PhilopatearSalib/pcleaner/A0 poster.pptx

PCleaner

Abstract

Our projects goal was to offer daily caring routines to medium sized swimming pools , owned by 30-50 year old males or females , in a villa or a compound.

Function

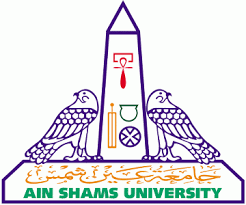
[picture p72: figure]

Ahmed Amr
Philopatear Salib
Nourhan Ayman

Product design

Design Thinking process

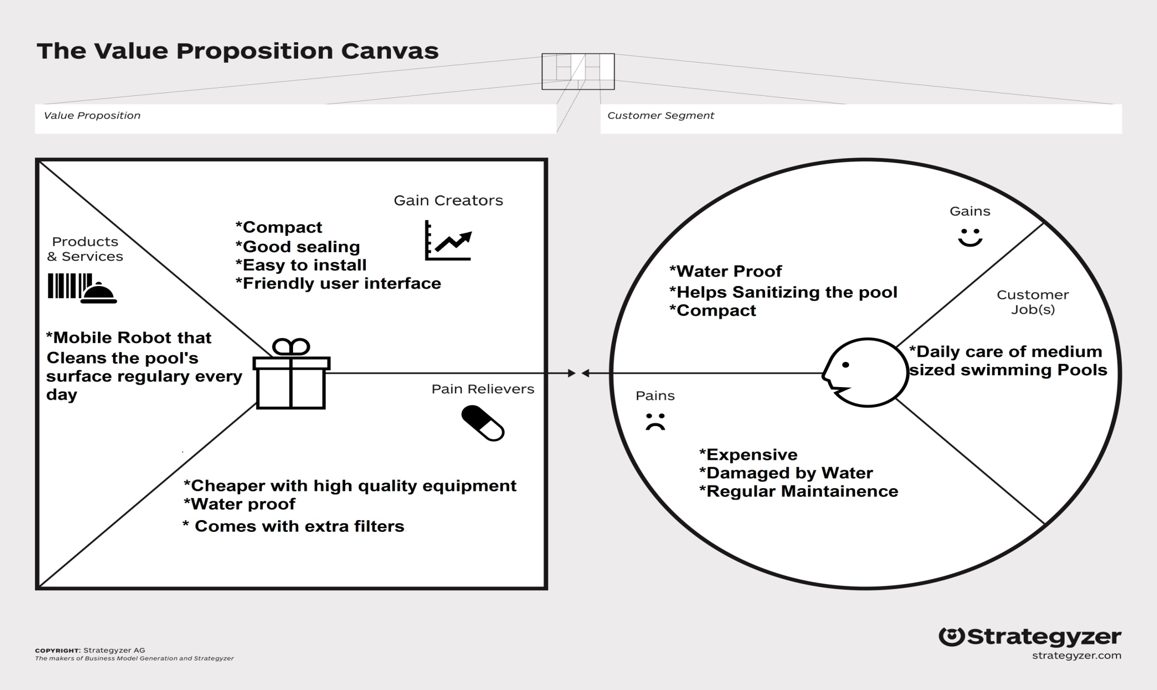
[picture p73: figure]

Business Model Canvas

Market research results

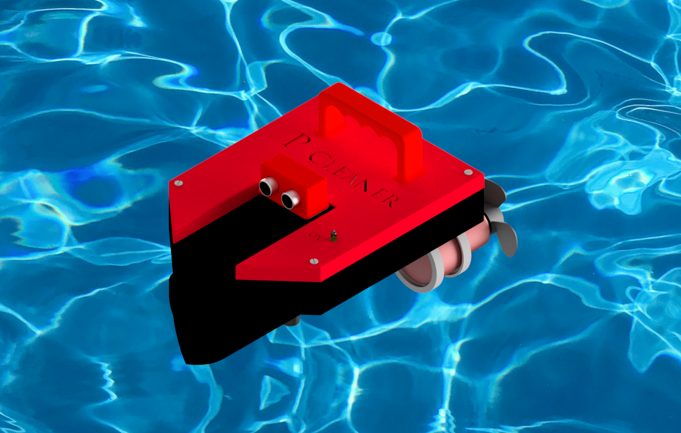
[picture p74: figure]

Our main goal was to clean any medium sized pool , in the most efficient way . And still maintaining privacy and safety. Our robot works autonomously , with a really simple user interface that requires no effort and has no complexity.

Project timeline

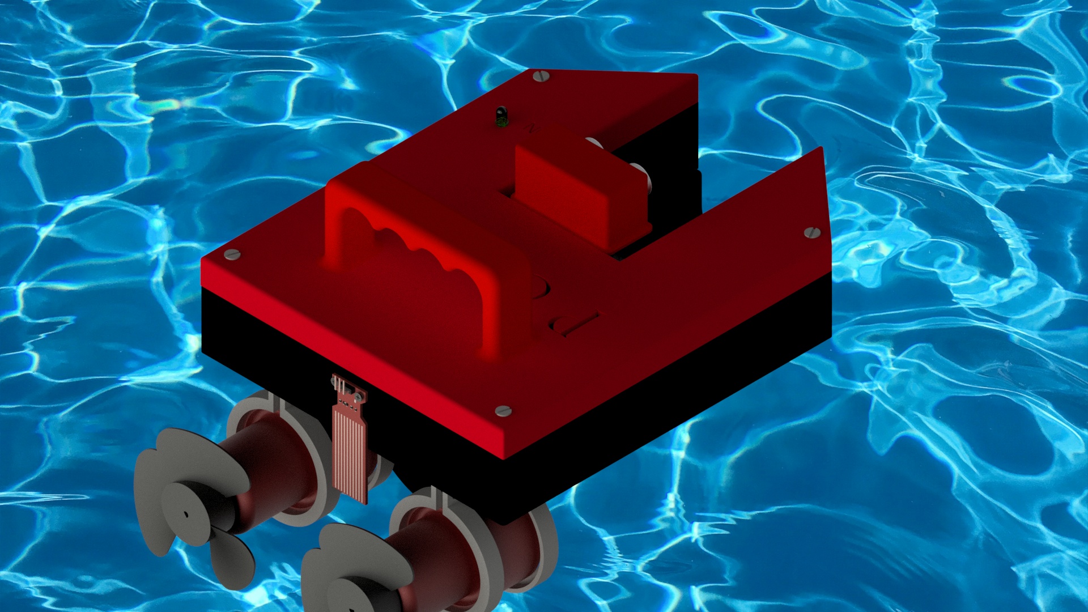
[picture p75: figure]
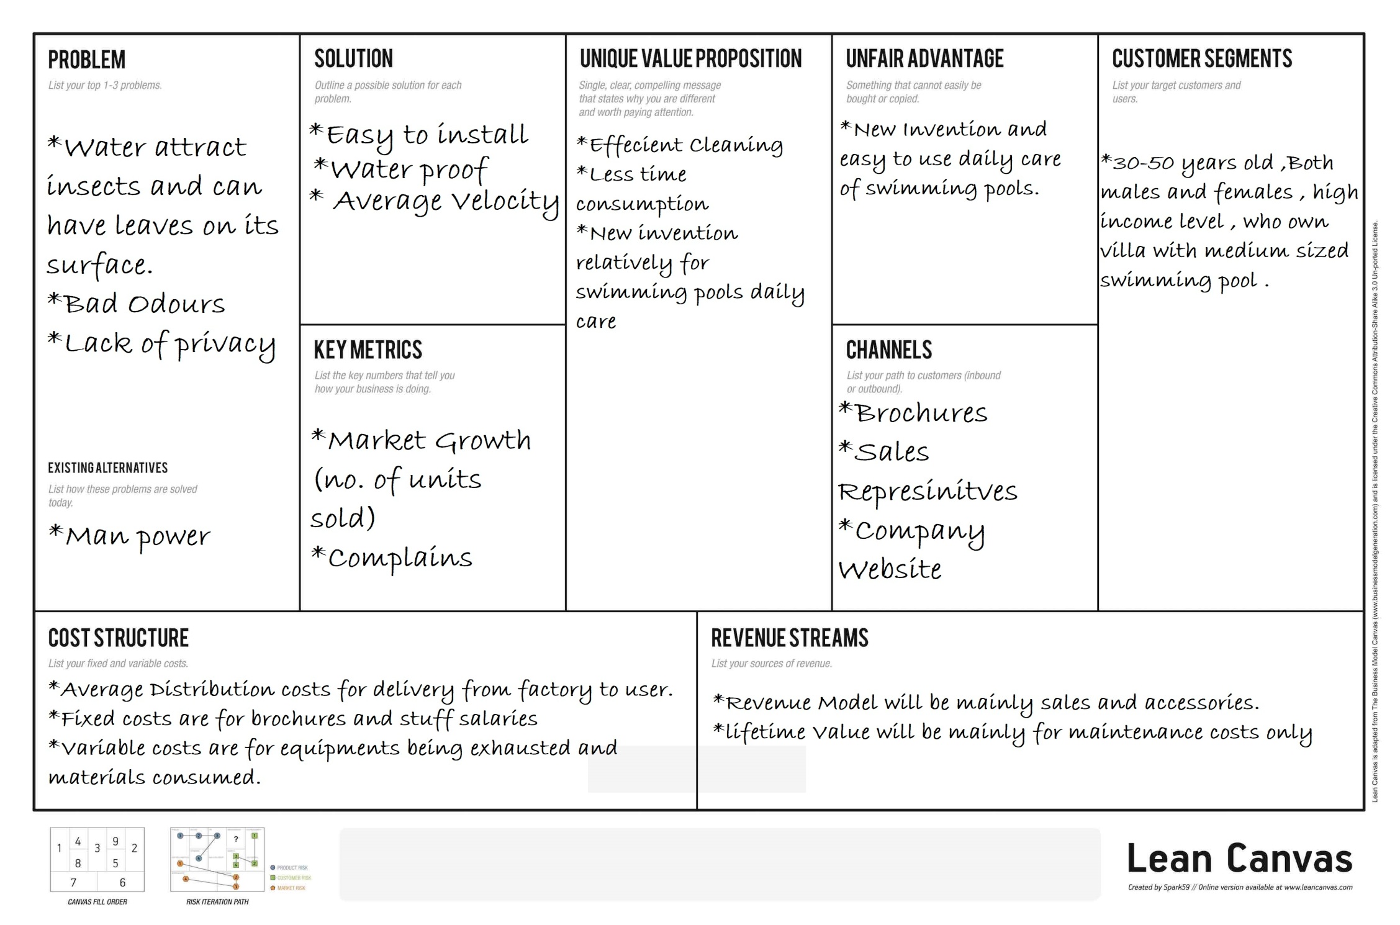
[picture p76: figure]

Lean Model Canvas

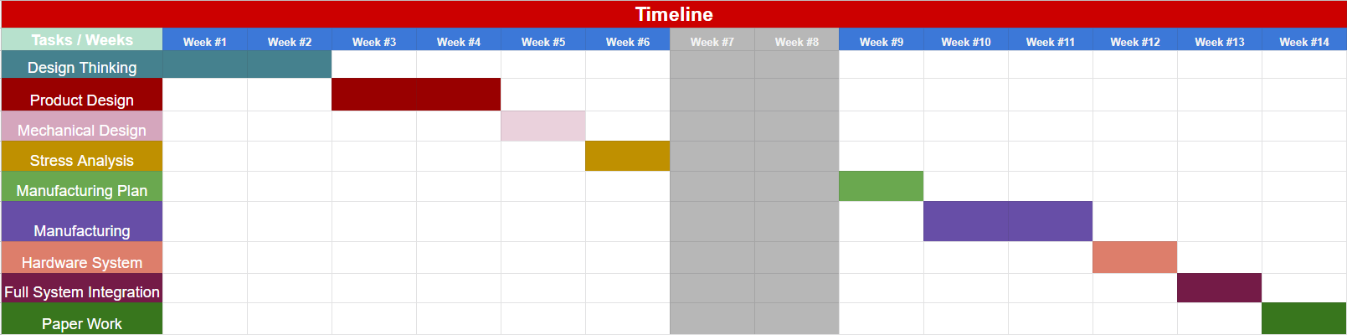
[picture p77: figure]

Specs and features

- Easy to install
- Compact
- Low time consumption cleaning
- Low maintenance time
- Very simple user interface

Bill of materials and cost

Electrical aspects


SID-Model

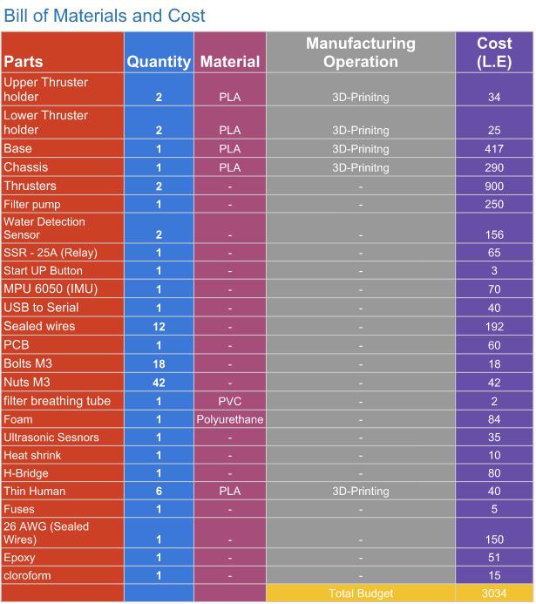
[picture p78: figure]
