PhilopatearSalib/pcleaner/56881405_650702132056410_6555122049436614656_n.jpg

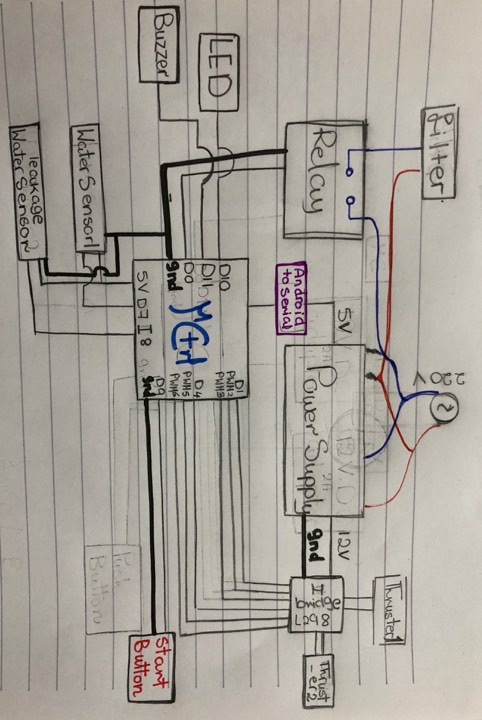
56881405_650702132056410_6555122049436614656_n.jpg
