PhilopatearSalib/pcleaner/AC to DC Converter/Capture.JPG

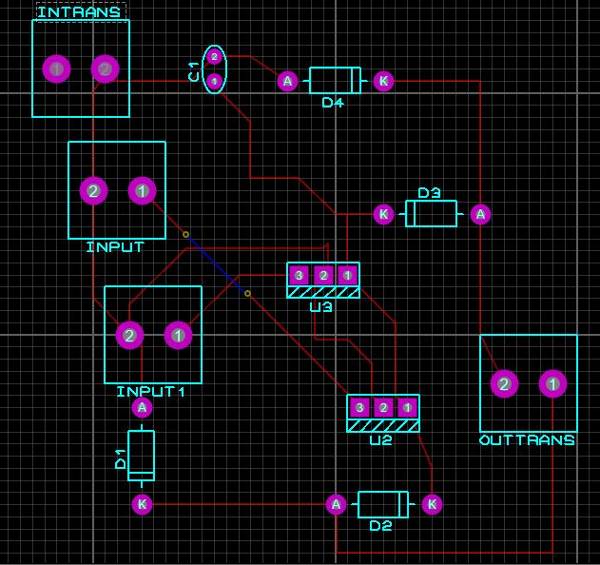
AC to DC Converter/Capture.JPG
