PhilopatearSalib/pcleaner/arduino/arduino.png

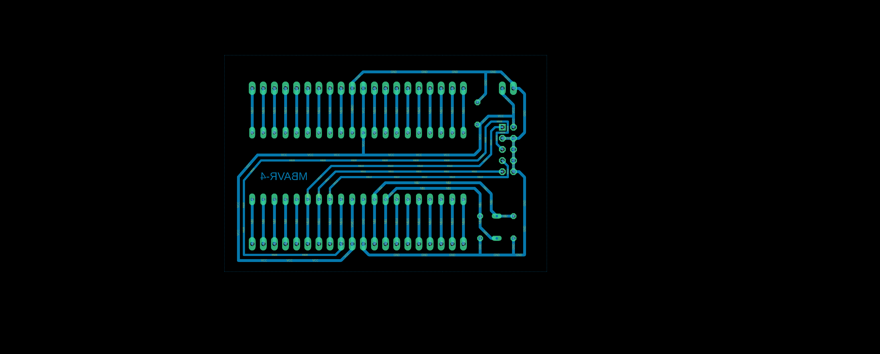
arduino/arduino.png
