PhilopatearSalib/pcleaner/Mother BlackBox.jpg

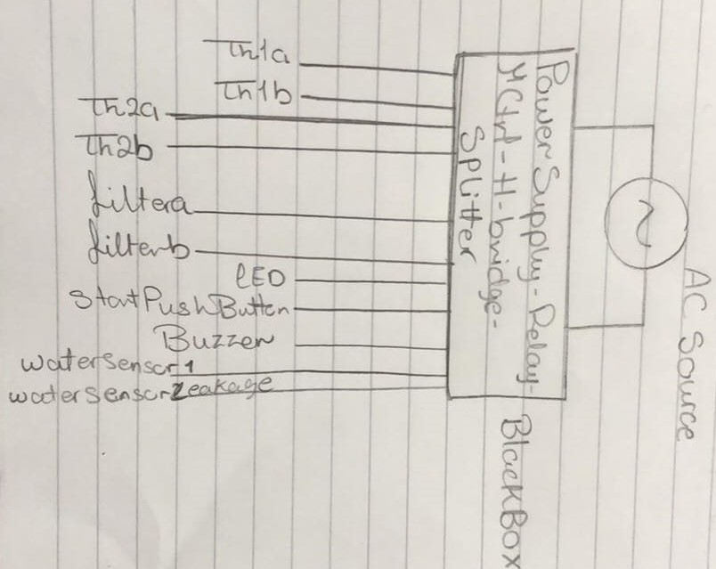
Mother BlackBox.jpg
