PhilopatearSalib/pcleaner/Mother SID Sketch.jpg

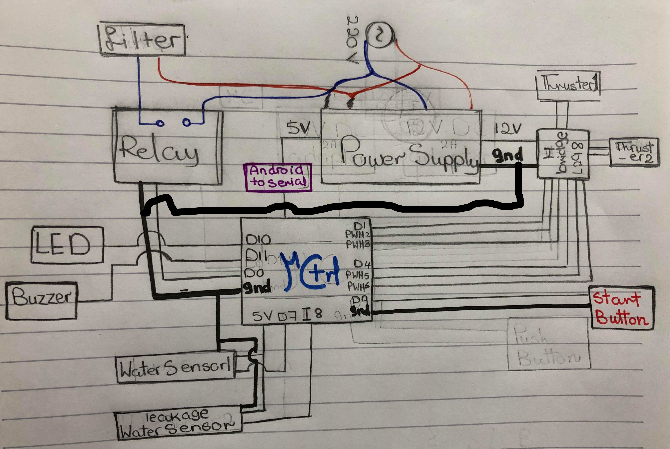
Mother SID Sketch.jpg
