PhilopatearSalib/pcleaner/water leakage sensor/Capture.JPG

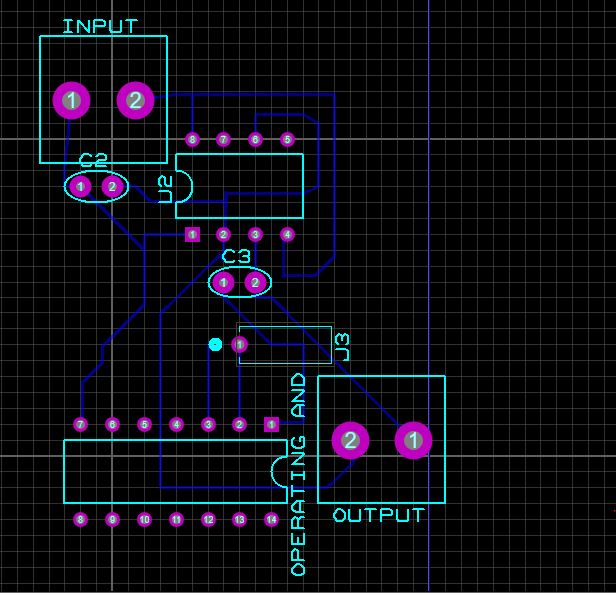
water leakage sensor/Capture.JPG
