PhilopatearSalib/pcleaner/CAD - PCleaner V5/PCleanerV3/Seaflo_BilgePump1100GPH_CAD_Model/Bilge Pump.SLDASM

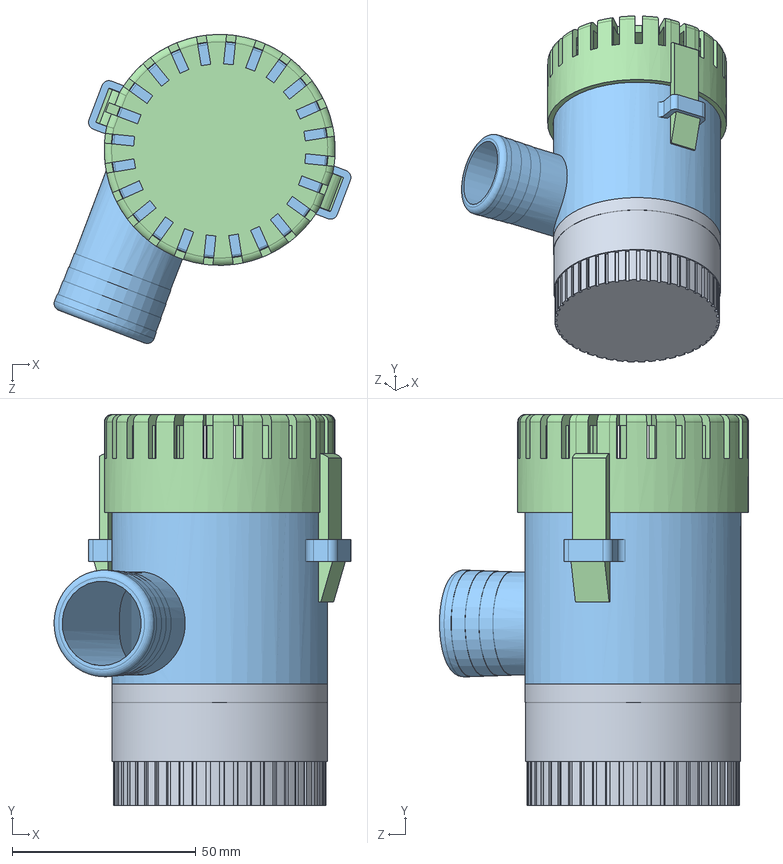
[picture p90: CAD file, 2019-05-22]
CAD - PCleaner V5/PCleanerV3/Seaflo_BilgePump1100GPH_CAD_Model/Bilge Pump.SLDASM
80.7 x 106.3 x 84.0 mm
Upper part
Bilge Axis
Middle part
Lower part
