PhilopatearSalib/pcleaner/3D cut parts/Base left arm.stl

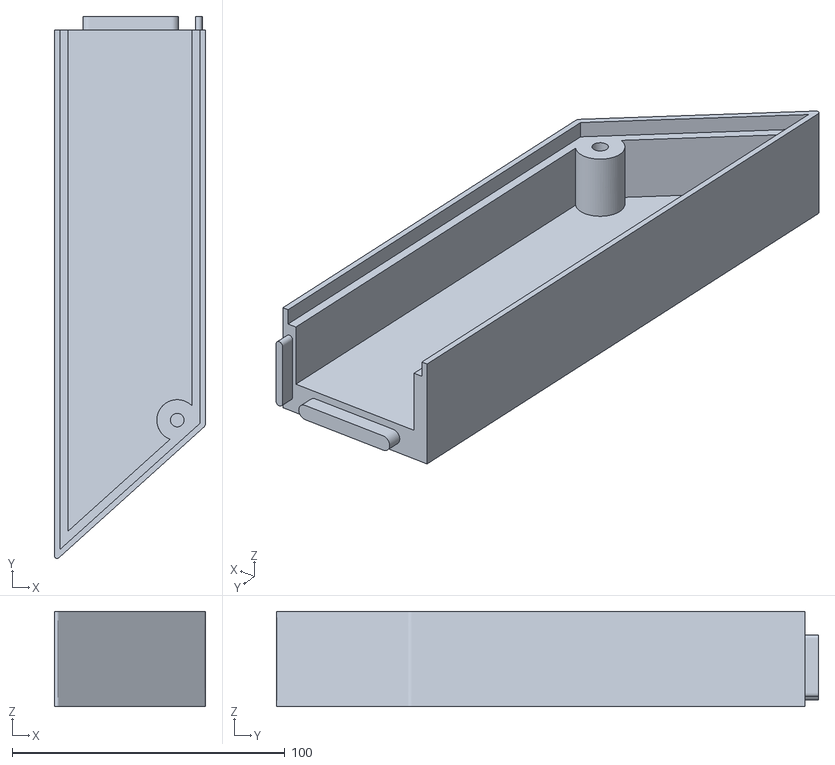
[picture p91: CAD file, 2019-05-22]
3D cut parts/Base left arm.stl
55.5 x 198.8 x 35.0
