PhilopatearSalib/pcleaner/CAD - PCleaner V5 (rev b)/PCleanerV5rar_2/PCleanerV3/Capteur Pluie2 v3.step

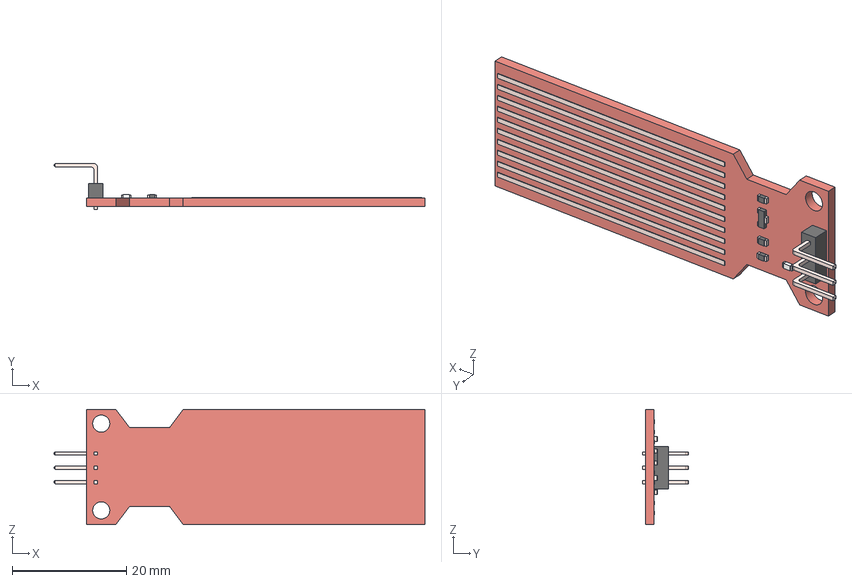
[picture p92: CAD file, 2019-05-22]
CAD - PCleaner V5 (rev b)/PCleanerV5rar_2/PCleanerV3/Capteur Pluie2 v3.step
65.0 x 8.00 x 20.2 mm
