PhilopatearSalib/pcleaner/CAD - PCleaner V5/PCleanerV3/Seaflo_BilgePump1100GPH_CAD_Model/Upper part.SLDPRT

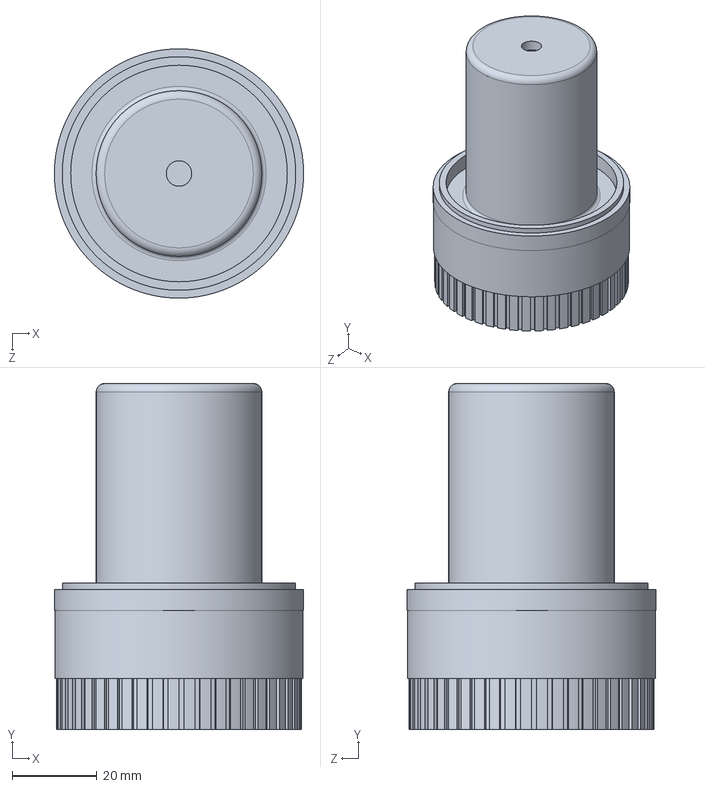
[picture p93: CAD file, 2019-05-22]
CAD - PCleaner V5/PCleanerV3/Seaflo_BilgePump1100GPH_CAD_Model/Upper part.SLDPRT
58.7 x 81.5 x 58.7 mm
