PhilopatearSalib/pcleaner/water leakage sensor/water sensor.DXF

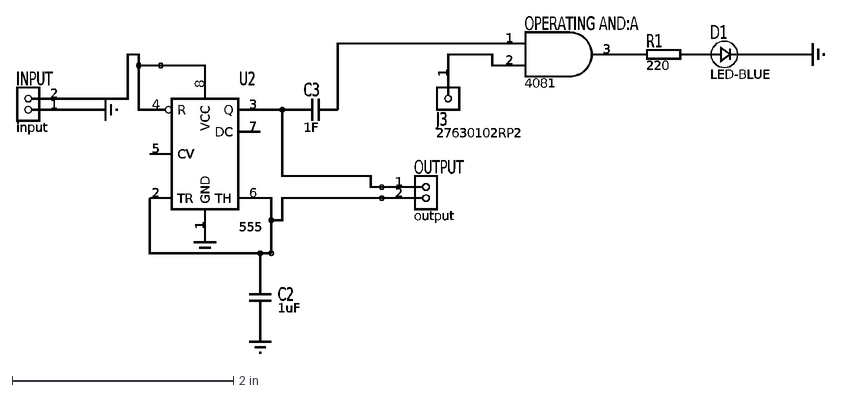
[picture p94: CAD file, 2019-05-22]
water leakage sensor/water sensor.DXF
R
4
DC
7
Q
3
GND
1
VCC
8
TR
2
TH
6
CV
5
U2
555
C2
1uF
C3
1F
OPERATING AND:A
4081
INPUT
input
OUTPUT
output
R1
220
D1
LED-BLUE
J3
27630102RP2
