PhilopatearSalib/pcleaner/3D cut parts/tube front.stl

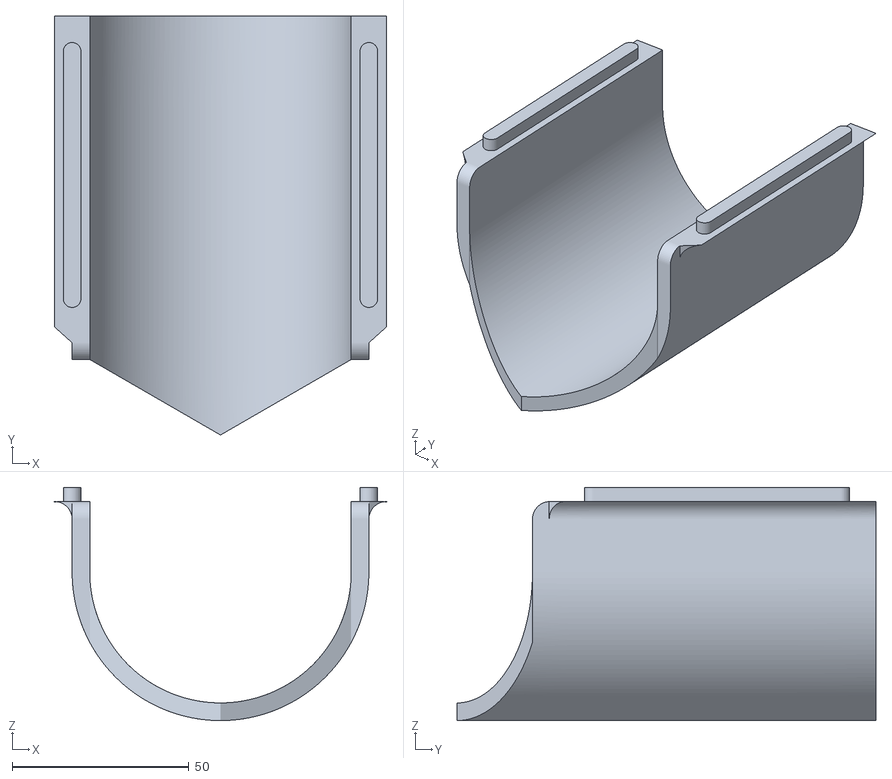
[picture p95: CAD file, 2019-05-22]
3D cut parts/tube front.stl
94.0 x 118.6 x 66.0
