PhilopatearSalib/pcleaner/CAD - PCleaner V5/PCleanerV3/Seaflo_BilgePump1100GPH_CAD_Model/Lower part.SLDPRT

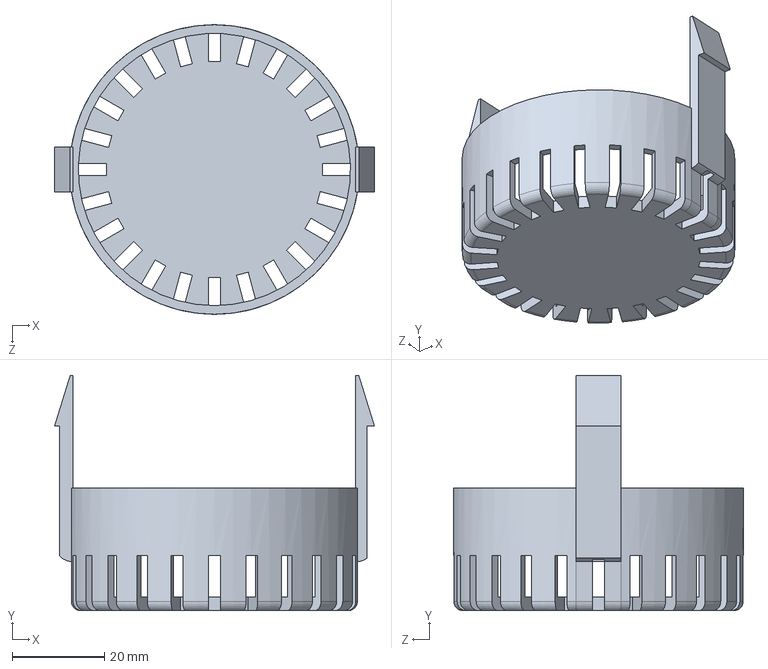
[picture p96: CAD file, 2019-05-22]
CAD - PCleaner V5/PCleanerV3/Seaflo_BilgePump1100GPH_CAD_Model/Lower part.SLDPRT
69.4 x 51.0 x 62.8 mm
