PhilopatearSalib/pcleaner/CAD - PCleaner V5/PCleanerV3/Seaflo_BilgePump1100GPH_CAD_Model/Middle part.SLDPRT

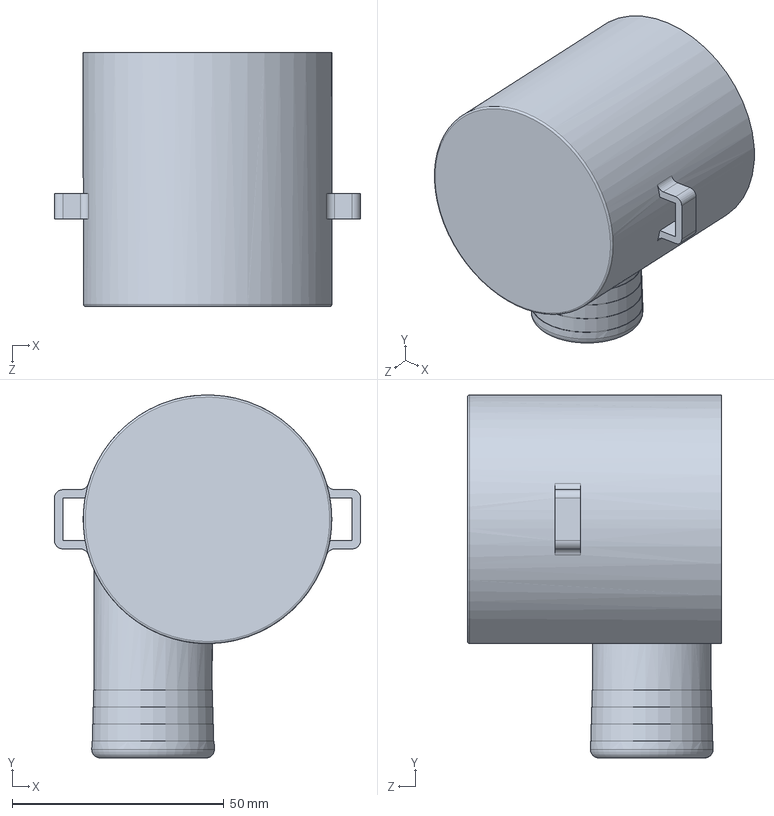
[picture p97: CAD file, 2019-05-22]
CAD - PCleaner V5/PCleanerV3/Seaflo_BilgePump1100GPH_CAD_Model/Middle part.SLDPRT
72.3 x 85.7 x 60.0 mm
