PhilopatearSalib/pcleaner/3D cut parts/chassis left arm.stl

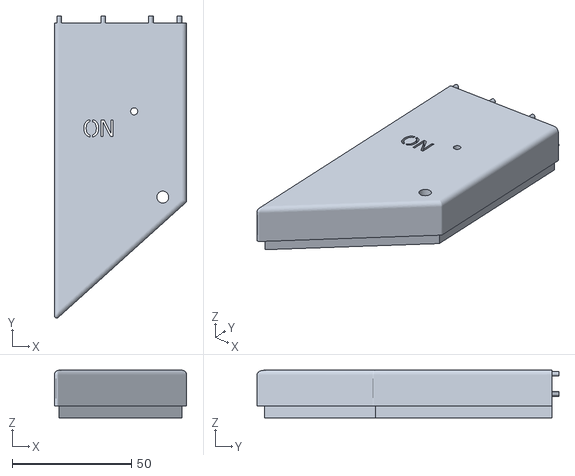
[picture p98: CAD file, 2019-05-22]
3D cut parts/chassis left arm.stl
55.5 x 126.8 x 20.0
