PhilopatearSalib/pcleaner/3D cut parts/Lower housing.stl

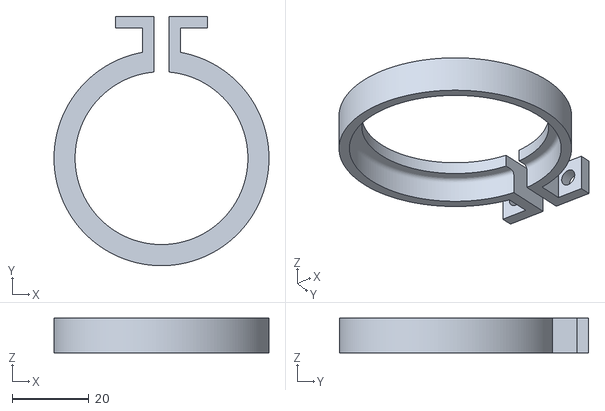
[picture p99: CAD file, 2019-05-22]
3D cut parts/Lower housing.stl
56.0 x 64.9 x 9.00
