PhilopatearSalib/pcleaner/3D cut parts/chassis back part.stl

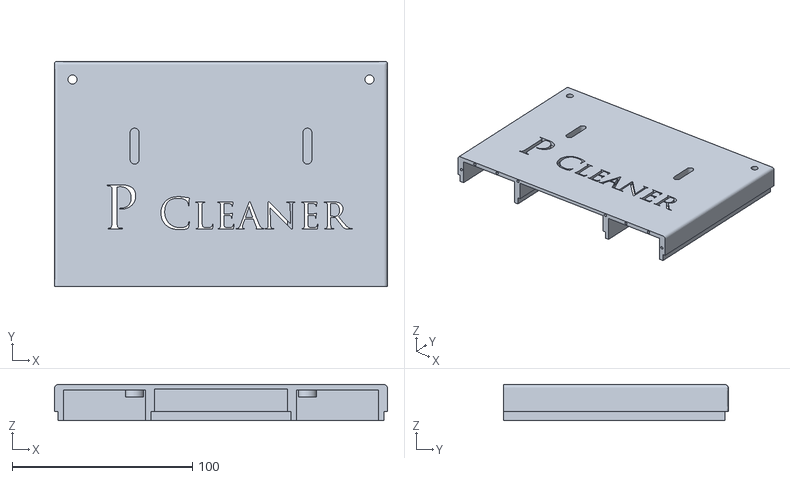
[picture p100: CAD file, 2019-05-22]
3D cut parts/chassis back part.stl
185.0 x 125.0 x 20.0
