PhilopatearSalib/pcleaner/3D cut parts/Fillets  ( 2x ).stl

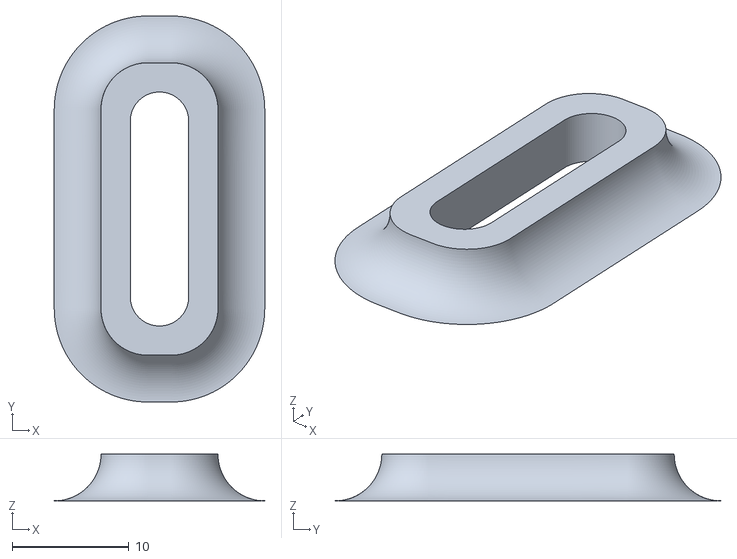
[picture p101: CAD file, 2019-05-22]
3D cut parts/Fillets ( 2x ).stl
18.0 x 33.0 x 4.00
