PhilopatearSalib/pcleaner/3D cut parts/base back part.stl

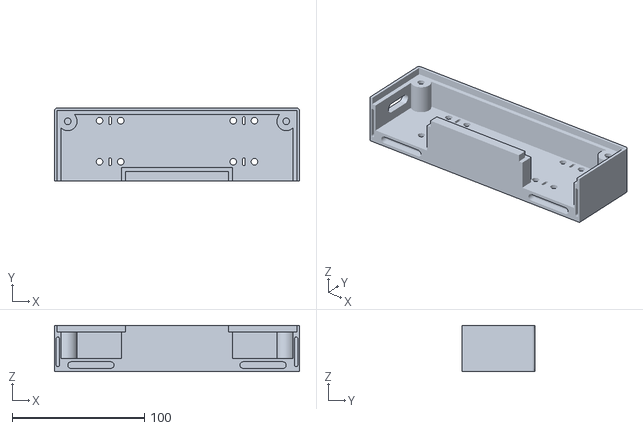
[picture p102: CAD file, 2019-05-22]
3D cut parts/base back part.stl
185.0 x 55.0 x 35.0
