PhilopatearSalib/pcleaner/3D cut parts/Tube back part.stl

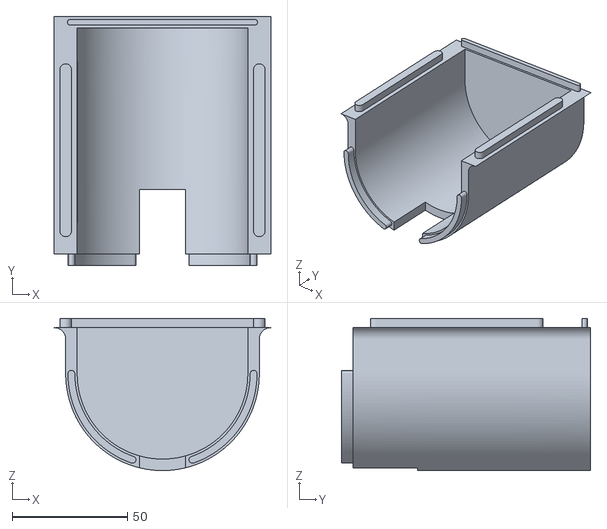
[picture p103: CAD file, 2019-05-22]
3D cut parts/Tube back part.stl
94.0 x 108.0 x 66.0
