PhilopatearSalib/pcleaner/3D cut parts/Handle.stl

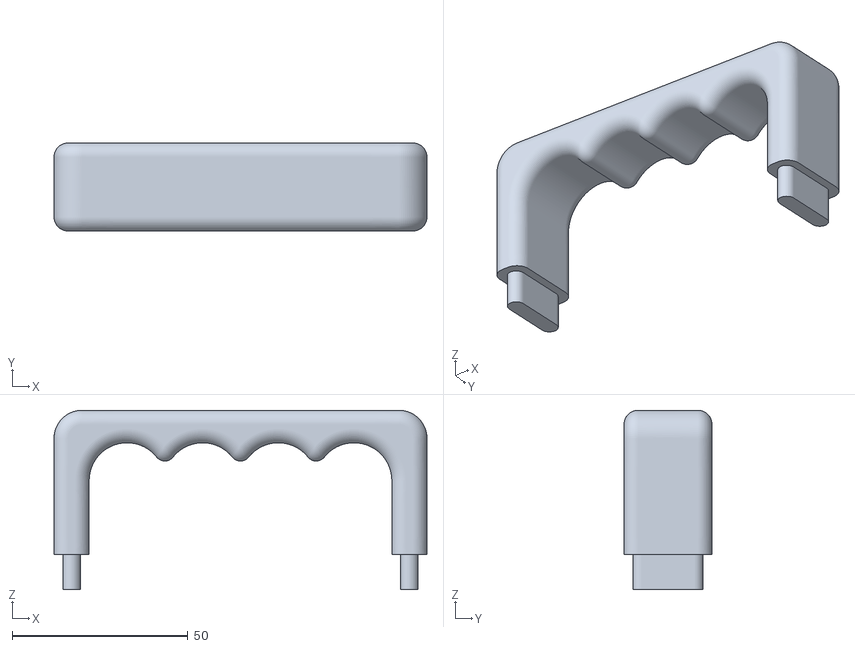
[picture p104: CAD file, 2019-05-22]
3D cut parts/Handle.stl
106.0 x 25.0 x 51.0
