PhilopatearSalib/pcleaner/CAD - PCleaner V4/Pcleaner V3/PCleanerV3/new base.stl

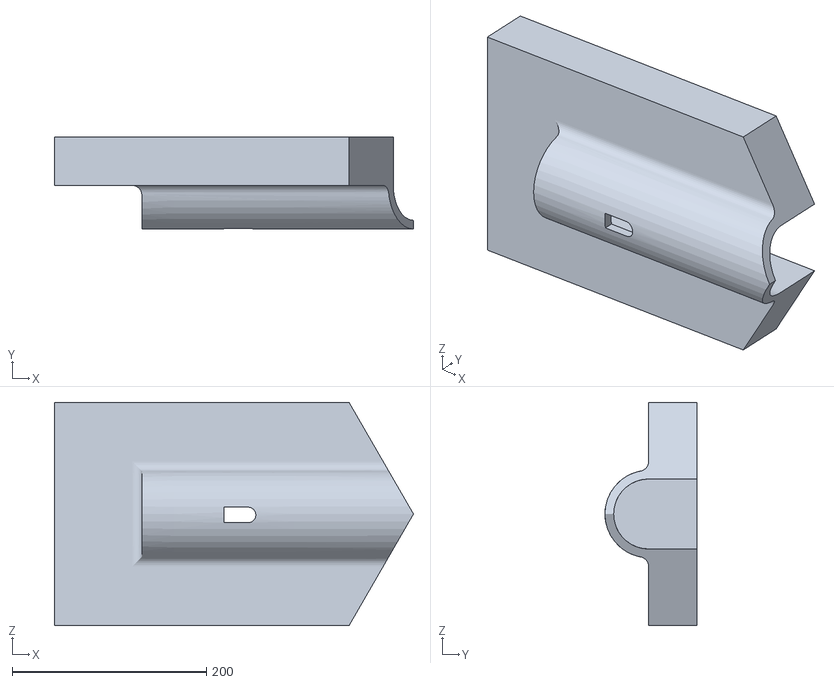
[picture p105: CAD file, 2019-05-22, an earlier design]
CAD - PCleaner V4/Pcleaner V3/PCleanerV3/new base.stl
370.0 x 95.0 x 230.0
