PhilopatearSalib/pcleaner/(list of files, cad)

Other CAD files:
3D cut parts/Base right arm.stl
3D cut parts/chassis right arm.stl
3D cut parts/Lower housing.ipt
3D cut parts/Tube back part.ipt
3D cut parts/base back part.ipt
3D cut parts/tube front.ipt
CAD - PCleaner V4/Pcleaner V3/PCleanerV3/5mm LED.ipt
CAD - PCleaner V4/Pcleaner V3/PCleanerV3/Bilge-pump.ipt
CAD - PCleaner V4/Pcleaner V3/PCleanerV3/Capteur Pluie2 v3.ipt
CAD - PCleaner V4/Pcleaner V3/PCleanerV3/OldVersions/Assembly1.0002.iam
CAD - PCleaner V4/Pcleaner V3/PCleanerV3/OldVersions/Button.0002.ipt
CAD - PCleaner V4/Pcleaner V3/PCleanerV3/OldVersions/Chassis.0022.ipt
CAD - PCleaner V4/Pcleaner V3/PCleanerV3/OldVersions/air pump tube.0004.ipt
CAD - PCleaner V4/Pcleaner V3/PCleanerV3/OldVersions/aquarium pump head.0010.ipt
CAD - PCleaner V4/Pcleaner V3/PCleanerV3/OldVersions/new base.0031.ipt
CAD - PCleaner V4/Pcleaner V3/PCleanerV3/PCleanerV3.iam
CAD - PCleaner V4/Pcleaner V3/PCleanerV3/PCleanerV3/Bilge Pump Holder.ipt
CAD - PCleaner V4/Pcleaner V3/PCleanerV3/PCleanerV3/OldVersions/5mm LED.0004.ipt
CAD - PCleaner V4/Pcleaner V3/PCleanerV3/PCleanerV3/OldVersions/Bilge Pump Holder.0003.ipt
CAD - PCleaner V4/Pcleaner V3/PCleanerV3/PCleanerV3/OldVersions/Bilge-pump.0001.ipt
CAD - PCleaner V4/Pcleaner V3/PCleanerV3/PCleanerV3/OldVersions/Bilge-pump.0002.ipt
CAD - PCleaner V4/Pcleaner V3/PCleanerV3/PCleanerV3/OldVersions/Chassis.0021.ipt
CAD - PCleaner V4/Pcleaner V3/PCleanerV3/PCleanerV3/OldVersions/PCleanerV3.0038.iam
CAD - PCleaner V4/Pcleaner V3/PCleanerV3/PCleanerV3/OldVersions/air pump tube.0003.ipt
CAD - PCleaner V4/Pcleaner V3/PCleanerV3/PCleanerV3/OldVersions/aquarium pump head.0009.ipt
CAD - PCleaner V4/Pcleaner V3/PCleanerV3/PCleanerV3/OldVersions/floating bed.0007.ipt
CAD - PCleaner V4/Pcleaner V3/PCleanerV3/PCleanerV3/OldVersions/new base.0029.ipt
CAD - PCleaner V4/Pcleaner V3/PCleanerV3/PCleanerV3/OldVersions/upper motor holder.0010.ipt
CAD - PCleaner V4/Pcleaner V3/PCleanerV3/PCleanerV3/PCleanerV3.iam
CAD - PCleaner V4/Pcleaner V3/PCleanerV3/PCleanerV3/Seaflo_BilgePump1100GPH_CAD_Model/Bilge Axis.SLDPRT
CAD - PCleaner V4/Pcleaner V3/PCleanerV3/PCleanerV3/floating bed.ipt
CAD - PCleaner V4/Pcleaner V3/PCleanerV3/PCleanerV3/new base.ipt
CAD - PCleaner V4/Pcleaner V3/PCleanerV3/Seaflo_BilgePump1100GPH_CAD_Model/Bilge Pump.ipt
CAD - PCleaner V4/Pcleaner V3/PCleanerV3/aquarium pump head.ipt
CAD - PCleaner V4/Pcleaner V3/PCleanerV3/new base.ipt
CAD - PCleaner V5 (rev b)/PCleanerV5rar_2/PCleanerV3/Bilge pump holder v5.ipt
CAD - PCleaner V5 (rev b)/PCleanerV5rar_2/PCleanerV3/CSN 02 1174 - B M5 x 45.ipt
CAD - PCleaner V5 (rev b)/PCleanerV5rar_2/PCleanerV3/Chassis.ipt
CAD - PCleaner V5 (rev b)/PCleanerV5rar_2/PCleanerV3/Foam v5.ipt
CAD - PCleaner V5 (rev b)/PCleanerV5rar_2/PCleanerV3/OldVersions/5mm LED.0005.ipt
CAD - PCleaner V5 (rev b)/PCleanerV5rar_2/PCleanerV3/OldVersions/Assembly1.0003.iam
CAD - PCleaner V5 (rev b)/PCleanerV5rar_2/PCleanerV3/OldVersions/Bilge pump holder v5.0011.ipt
CAD - PCleaner V5 (rev b)/PCleanerV5rar_2/PCleanerV3/OldVersions/Bilge-pump.0003.ipt
CAD - PCleaner V5 (rev b)/PCleanerV5rar_2/PCleanerV3/OldVersions/Capteur Pluie2 v3.0001.ipt
CAD - PCleaner V5 (rev b)/PCleanerV5rar_2/PCleanerV3/OldVersions/Chassis - Edited - no height.0030.ipt
CAD - PCleaner V5 (rev b)/PCleanerV5rar_2/PCleanerV3/OldVersions/Foam v5.0005.ipt
CAD - PCleaner V5 (rev b)/PCleanerV5rar_2/PCleanerV3/OldVersions/Pump Holder.0017.ipt
CAD - PCleaner V5 (rev b)/PCleanerV5rar_2/PCleanerV3/OldVersions/aquarium pump head.0012.ipt
CAD - PCleaner V5 (rev b)/PCleanerV5rar_2/PCleanerV3/OldVersions/assembly v5.0012.iam
CAD - PCleaner V5 (rev b)/PCleanerV5rar_2/PCleanerV3/OldVersions/base v5.0012.ipt
CAD - PCleaner V5 (rev b)/PCleanerV5rar_2/PCleanerV3/OldVersions/chassis v5.0011.ipt
CAD - PCleaner V5 (rev b)/PCleanerV5rar_2/PCleanerV3/OldVersions/fork v5.0008.ipt
CAD - PCleaner V5 (rev b)/PCleanerV5rar_2/PCleanerV3/OldVersions/new base.0037.ipt
CAD - PCleaner V5 (rev b)/PCleanerV5rar_2/PCleanerV3/OldVersions/plates.0003.ipt
CAD - PCleaner V5 (rev b)/PCleanerV5rar_2/PCleanerV3/OldVersions/pump filter.0004.ipt
CAD - PCleaner V5 (rev b)/PCleanerV5rar_2/PCleanerV3/OldVersions/pump tube.0007.ipt
CAD - PCleaner V5 (rev b)/PCleanerV5rar_2/PCleanerV3/OldVersions/truss upper v5.0003.ipt
CAD - PCleaner V5 (rev b)/PCleanerV5rar_2/PCleanerV3/OldVersions/truss v5.0002.ipt
CAD - PCleaner V5 (rev b)/PCleanerV5rar_2/PCleanerV3/Pump Holder.ipt
CAD - PCleaner V5 (rev b)/PCleanerV5rar_2/PCleanerV3/assembly v5.iam
CAD - PCleaner V5 (rev b)/PCleanerV5rar_2/PCleanerV3/base v5.ipt
CAD - PCleaner V5 (rev b)/PCleanerV5rar_2/PCleanerV3/chassis v5.ipt
CAD - PCleaner V5 (rev b)/PCleanerV5rar_2/PCleanerV3/fork v5.ipt
CAD - PCleaner V5 (rev b)/PCleanerV5rar_2/PCleanerV3/plates.ipt
CAD - PCleaner V5 (rev b)/PCleanerV5rar_2/PCleanerV3/prop.ipt
CAD - PCleaner V5 (rev b)/PCleanerV5rar_2/PCleanerV3/pump tube.ipt
CAD - PCleaner V5 (rev b)/PCleanerV5rar_2/PCleanerV3/truss upper v5.ipt
CAD - PCleaner V5/PCleanerV3/Assembly v3 without mistakes (12-4 ).iam
CAD - PCleaner V5/PCleanerV3/Assembly1.iam
CAD - PCleaner V5/PCleanerV3/Bilge Pump Holder.ipt
CAD - PCleaner V5/PCleanerV3/Bilge pump holder v5.ipt
CAD - PCleaner V5/PCleanerV3/Button.ipt
CAD - PCleaner V5/PCleanerV3/Chassis - Edited - no height.ipt
CAD - PCleaner V5/PCleanerV3/OldVersions/Assembly v3 without mistakes (12-4 ).0001.iam
CAD - PCleaner V5/PCleanerV3/OldVersions/Bilge Pump Holder.0005.ipt
CAD - PCleaner V5/PCleanerV3/OldVersions/Bilge Pump Holder.0006.ipt
CAD - PCleaner V5/PCleanerV3/OldVersions/Bilge pump holder v5.0007.ipt
CAD - PCleaner V5/PCleanerV3/OldVersions/CSN 02 1174 - B M5 x 45.0002.ipt
CAD - PCleaner V5/PCleanerV3/OldVersions/Chassis.0023.ipt
CAD - PCleaner V5/PCleanerV3/OldVersions/Foam v5.0003.ipt
CAD - PCleaner V5/PCleanerV3/OldVersions/Foam v5.0004.ipt
CAD - PCleaner V5/PCleanerV3/OldVersions/assembly v5.0003.iam
CAD - PCleaner V5/PCleanerV3/OldVersions/base v5.0005.ipt
CAD - PCleaner V5/PCleanerV3/OldVersions/base v5.0006.ipt
CAD - PCleaner V5/PCleanerV3/OldVersions/chassis v5.0008.ipt
CAD - PCleaner V5/PCleanerV3/OldVersions/chassis v5.0009.ipt
CAD - PCleaner V5/PCleanerV3/OldVersions/floating bed.0011.ipt
CAD - PCleaner V5/PCleanerV3/OldVersions/prop.0007.ipt
CAD - PCleaner V5/PCleanerV3/air pump tube.ipt
CAD - PCleaner V5/PCleanerV3/aquarium pump head.ipt
CAD - PCleaner V5/PCleanerV3/assembly v5.iam
CAD - PCleaner V5/PCleanerV3/base v5.ipt
CAD - PCleaner V5/PCleanerV3/chassis v5.ipt
CAD - PCleaner V5/PCleanerV3/floating bed.ipt
CAD - PCleaner V5/PCleanerV3/new base.ipt
CAD - PCleaner V5/PCleanerV3/pump filter.ipt
