PhilopatearSalib/pcleaner/(list of files, drawings)

Other design files:
AC to DC Converter/AC to DC Converter.pdsprj
arduino/arduino.pdsprj
Children.pdsprj
Motherboard.pdsprj
SON.fzz
water leakage sensor/water sensor.pdsprj
